ireun/esphome-lg-controller/hardware-SeeedXiaoC6/SeeedXiaoC6.kicad_pcb

## KiCad design hardware-SeeedXiaoC6/SeeedXiaoC6.kicad_pcb (2025-11-12)

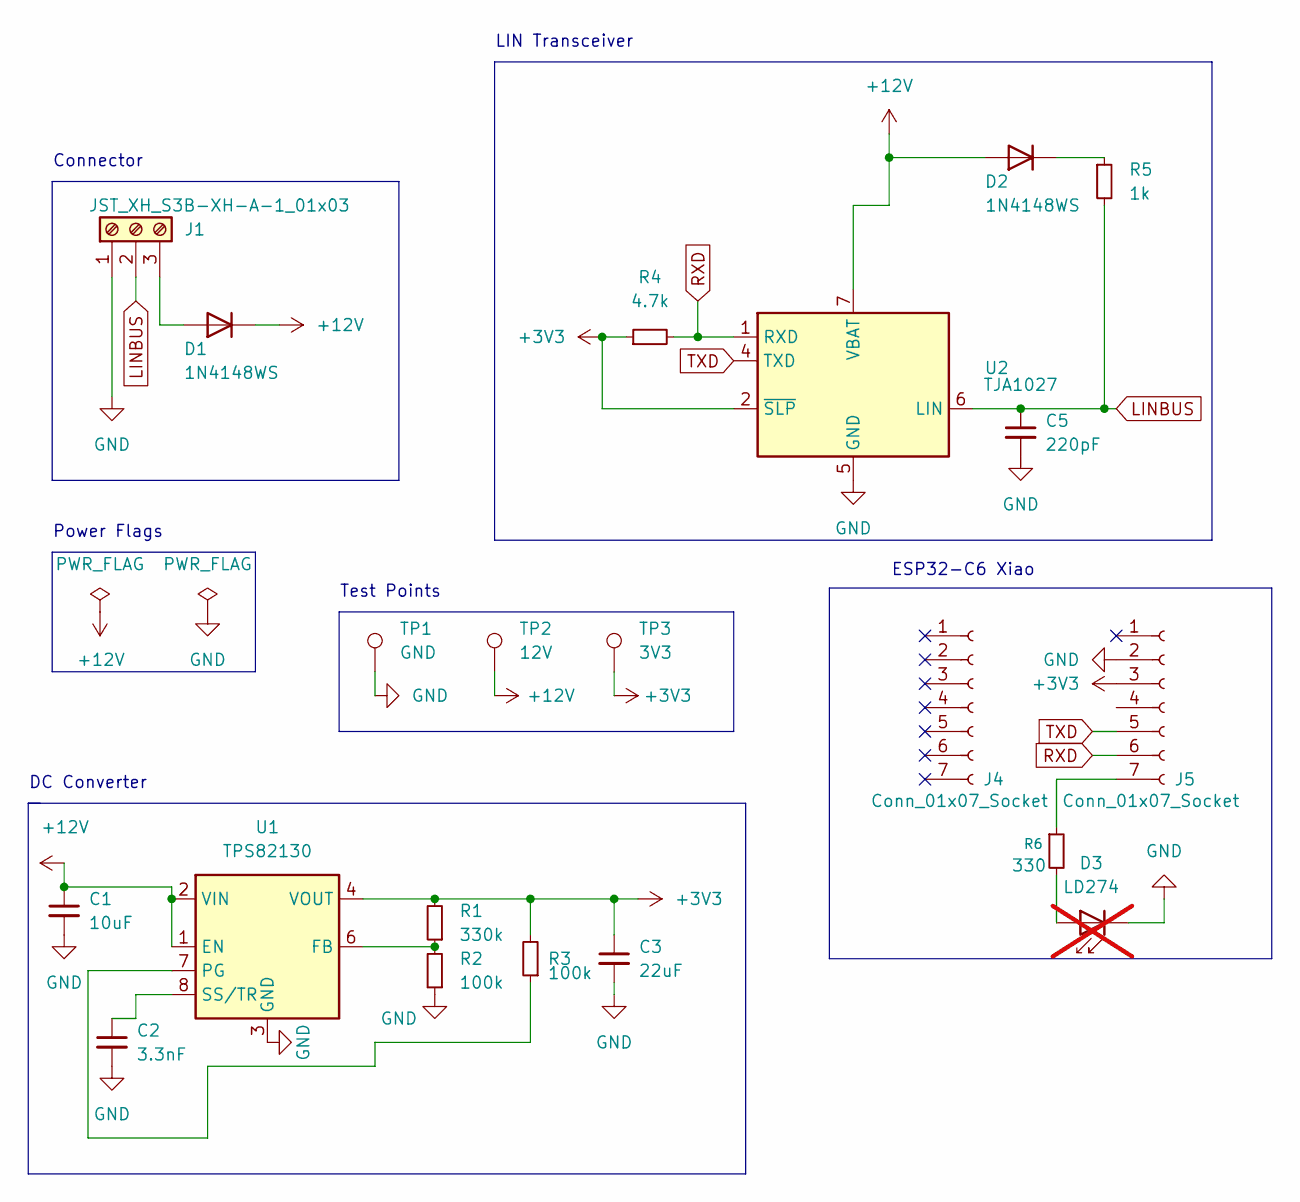
[picture p4: schematic SeeedXiaoC6.kicad_sch, ESP32 DevKit LG HVAC Controller Board]

Parts:
C1: 10uF; C_1210_3225Metric; LCSC C92834
C2: 3.3nF; C_0402_1005Metric; LCSC C26404
C3: 22uF; C_0805_2012Metric; LCSC C342717
C5: 220pF; C_0402_1005Metric; LCSC C343058
D1, D2: 1N4148WS; D_SOD-323; LCSC C727111
D3: LD274; LED_D5.0mm_IRGrey; not fitted
J1: JST_XH_S3B-XH-A-1_01x03; JST_XH_S3B-XH-A-1_1x03_P2.50mm_Horizontal; LCSC C157928
J4, J5: Conn_01x07_Socket; PinSocket_1x07_P2.54mm_Vertical
R1: 330k; R_0805_2012Metric; LCSC C17629
R2, R3: 100k; R_0805_2012Metric; LCSC C149504
R4: 4.7k; R_0805_2012Metric; LCSC C17673
R5: 1k; R_0805_2012Metric; LCSC C17513
R6: 330; R_0805_2012Metric
TP1: GND; TestPoint_Pad_D1.0mm
TP2: 12V; TestPoint_Pad_D1.0mm
TP3: 3V3; TestPoint_Pad_D1.0mm
U1: TPS82130; Texas_SIL0008D_MicroSiP-8-1EP_2.8x3mm_P0.65mm_EP1.1x1.9mm_T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; LCSC C473914
U2: TJA1027; SOIC-8_3.9x4.9mm_P1.27mm; LCSC C194371

Connections:
+3V3: C3.1, J5.3, R1.2, R3.2, R4.1, TP3.1, U1.4 (VOUT), U1.5 (VOUT), U2.2 (~SLP)
+12V: C1.1, D1.1 (K), D2.2 (A), TP2.1, U1.1 (EN), U1.2 (VIN), U2.7 (VBAT)
GND: C1.2, C2.2, C3.2, C5.2, D3.1 (K), J1.1, J5.2, R2.1, TP1.1, U1.3 (GND), U1.9 (GND), U2.5 (GND)
LINBUS: C5.1, J1.2, R5.2, U2.6 (LIN)
unnamed: D1.2 (A), J1.3
unnamed: D2.1 (K), R5.1
unnamed: D3.2 (A), R6.2
unnamed: J5.7, R6.1
unnamed: R1.1, R2.2, U1.6 (FB)
unnamed: R3.1, U1.7 (PG)
unnamed: C2.1, U1.8 (SS/TR)
RXD: J5.6, R4.2, U2.1 (RXD)
TXD: J5.5, U2.4 (TXD)

Notes on the sheet:
DC Converter
Connector
Test Points
LIN Transceiver
Power Flags
ESP32-C6 Xiao

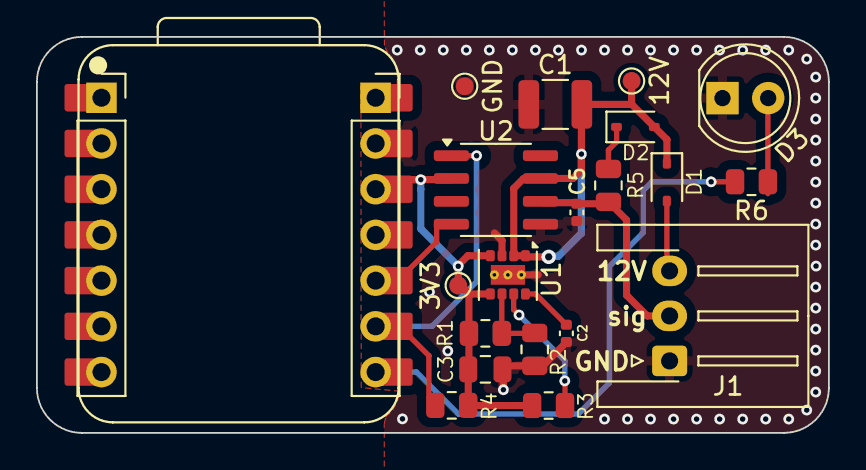
[picture p5: board SeeedXiaoC6.kicad_pcb from above]

Board: 2 copper layers, 44.0 x 22.0 mm, 21 parts (0 on the bottom side), 13 nets.
