ireun/esphome-lg-controller/(commit log)

2025-11-12 Add (work in progress) hardware version for Seeed Xiao ESP32-C6
    [SeeedXiaoC6.kicad_pcb, SeeedXiaoC6.kicad_sch]
2025-11-12 flatten dir
    [SeeedXiaoC6.kicad_pcb, SeeedXiaoC6.kicad_sch]
